vladak/workmon/README.md

# workmon

In the beginning of the [pandemic](https://en.wikipedia.org/wiki/COVID-19), the company offices went closed rather quickly and I found myself working with my laptop placed on a piano. The initial shock held for a long time, I spent couple of months working like that. This was not good for my posture (mental and physical) at all.

Later on, I built a very nice setup around [motorized standing desk](https://www.fully.com/standing-desks.html) with all the bells and whistles - quite meticulous cable management, custom oak wooden top (expensive), BenQ LED light placed on external display, IKEA pegboard on the wall next to the table to hold the essentials (like noise cancelling headphones, pens, SPARC assembly cheat-sheet, etc.), ~[Varmilo keyboard](https://en.varmilo.com/)~ [Keychron keyboard](https://www.keychron.com/products/keychron-v10-max-qmk-via-wireless-custom-mechanical-keyboard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), [Grovemade desk pad](https://grovemade.com/product/matte-desk-pad/?initial=533), WiFi extender AP mounted underneath the desk, professionally framed pictures/drawings on the wall, a small plant, etc.

Using this setup allowed me to be very productive, possibly more productive than in the office, to the point when I wanted to know more about how I work to make the increased [productivity levels sustainable](https://drmaciver.substack.com/p/people-dont-work-as-much-as-you-think).

When shopping around for parts of another project on [Adafruit](https://adafruit.com), I remembered an interesting presentation from [GrafanaCon 2021](https://grafana.com/about/events/grafanacon/2021/) called [WFH habits during lockdown told by Grafana](https://grafana.com/go/grafanaconline/2021/grafana-wfh-habits/) where the presenter used sensor paired with Grafana to monitor her WFH behavior w.r.t. breaks etc. This made me throw some more stuff to the Adafruit order, scavenge some parts laying around and make my own version of work habits monitoring setup.

My goal is to provide the following functionality:
  - determine the hours I work (per day/week)
    - turn on a warning that I should wrap for the day
    - send an alert if I have been working for too long in a given week (via Grafana + PagerDuty)
  - warn if I spend too much configuous time sitting/standing
    - similarly warn if I work for too long without a break
  - monitor the working environment, esp. CO2 concentration, and alert if above given threshold

## Hardware

- [ReverseTFT Feather](https://www.adafruit.com/product/5691)
- TP-link P110 smart WiFi plug
  - my primary display is connected to this plug 
  - this is used to detect my presence in front of the computer. This works with sufficient degree of precision because my display has the saver set just to 3 minutes.
    - while the presence could be detected in software, I wanted to avoid any changes whatsoever to the software of my company provided laptop. Other metrics such as light emitted by the display would not be as reliable.
- [US-100 Ultrasonic Distance Sensor](https://www.adafruit.com/product/4019) connected directly (soldered) to the Feather
  - to determine if the table is up/down
- iPhone headphones transparent plastic box used as a housing for the distance sensor
  - to be mounted underneath the table at the back in order not to cause measurement interference with my legs/chair etc.
- 4-strand phone cable to connect the distance sensor to the Feather
  - originally I wanted the cable to be split and outfitted with RJ11 connectors and connected using a connecting piece so that the sensor can be easily disconnected, however this connection turned out to be flaky so in the end I soldered it.
- [QtPy](https://learn.adafruit.com/adafruit-qt-py) with temperature/humidity and CO2 sensors
  - running the code from my [shield project](https://github.com/vladak/shield)
  - publishing messages with the metrics to a MQTT topic. The Feather will subscribe to the topic and handle the values.
- [3D printed stand](https://learn.adafruit.com/stand-for-feather-esp32-with-reverse-tft)

This is the 2nd version. See below for older versions.

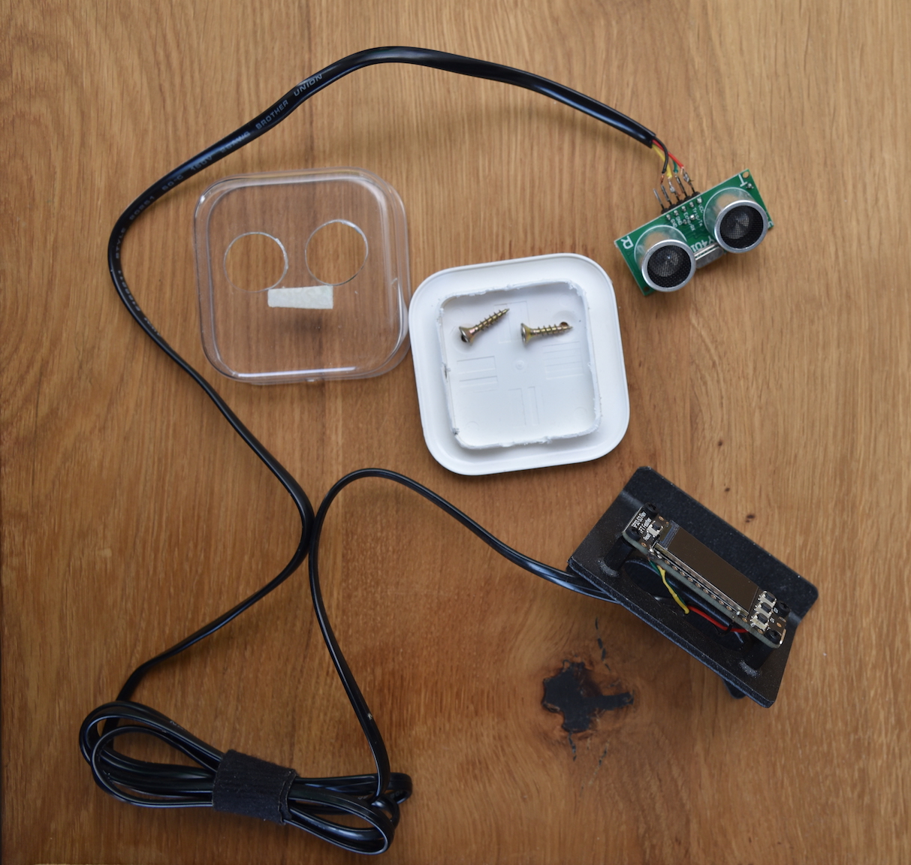
[picture p1: img/parts.jpg]
some of the parts

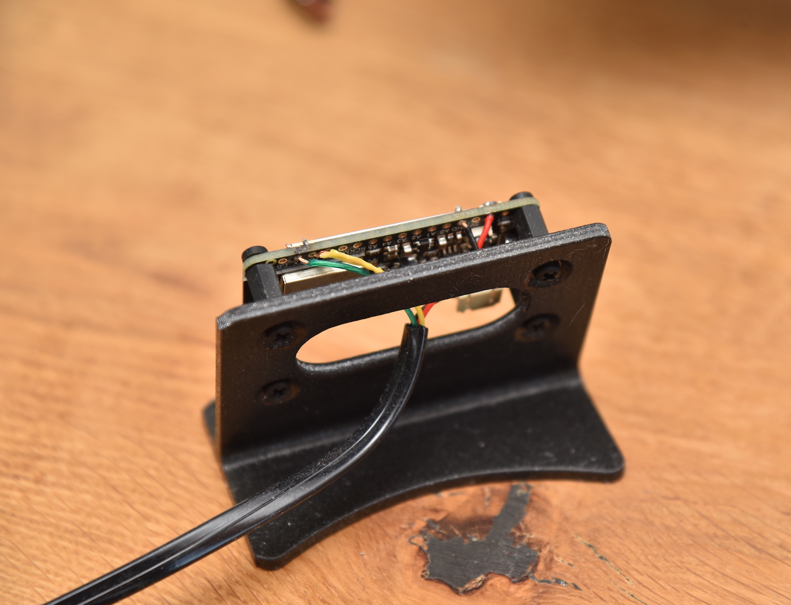
[picture p2: img/back.jpg]
back of the Feather

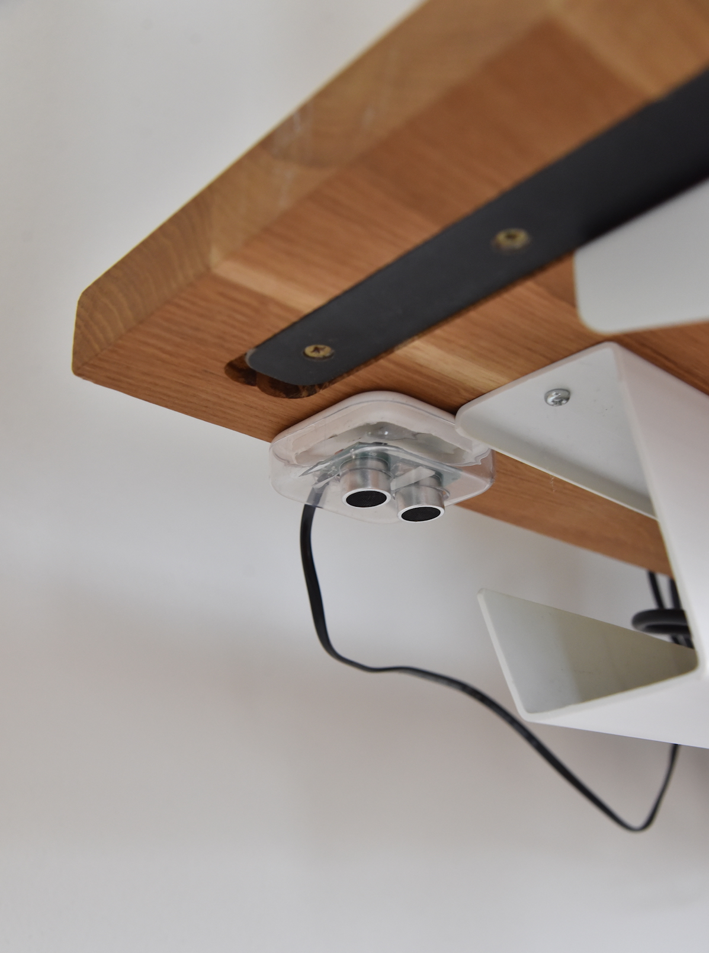
[picture p3: img/table.jpg]
ultrasonic sensor mounted underneath the table

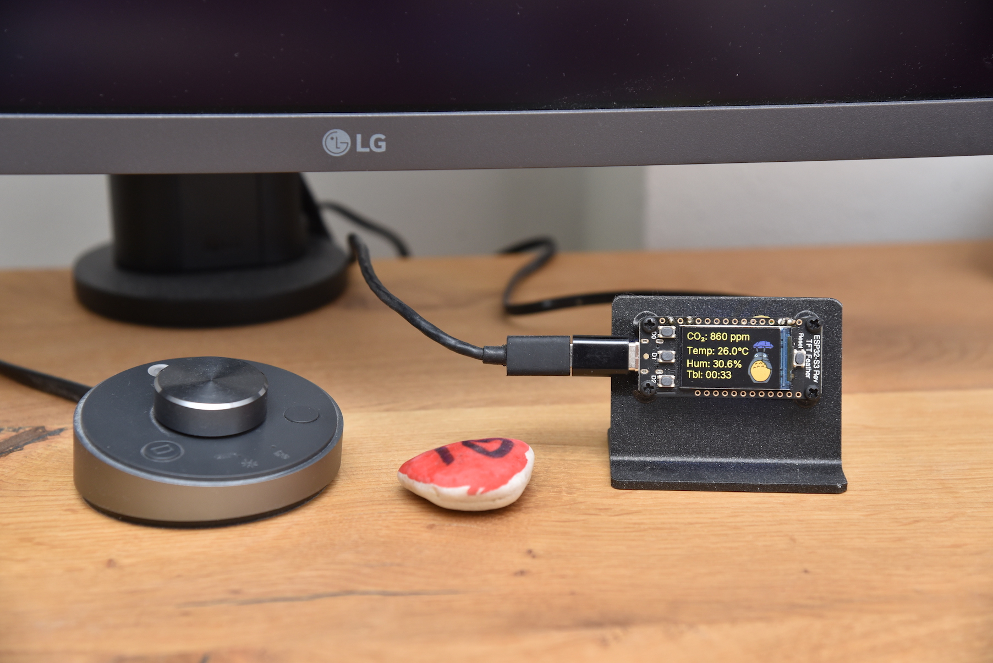
[picture p4: img/front.jpg]
front side


## Features

- by default a set of metrics is displayed: CO2, tmperature, humidity and the duration of the current table position. Also, image is displayed if available.
- The CO2 metric displayed will turn red if the value is greater than a configured threshold.
  - also, the Neopixel on the back side will start blinking red
- If the table is in the same position for too long (configurable) while the monitored power is on, the image will be changed and the neopixel on the back side will start blinking blue.
  - the table state tracking depends on the monitored power to be above certain threshold (i.e. **computer** display being on)
- If the monitored power is on longer than configured threshold, the neopixel will start blinking green.
- the display is on only during certain hours (configurable)
- if the display is off, pushing any D0/D1/D2 button will turn it on for a minute.

The blinking of the neopixel is prioritized so that it will blink with the color corresponding to the highest priority alert.

## History

Originally, this was based on a Raspberry Pi with a directly attached USB hub to connect the distance reader and 
a [light bulb with 3 lights](https://www.adafruit.com/product/5127) which was used to do the alerting.
The ultrasonic distance sensor was placed in original iPhone plastic box (the one with the transparent cover) with two holes for the sensor.
The Rpi died suddenly and I found more fun "architecture" based on microcontrollers.

Also, I believe the placement of the distance sensor was causing [value flapping](https://github.com/vladak/workmon/issues/10). 
It was attached with double sticky tape the white cable holder underneath the table on the right side and was not fully in horizontal position which is 
possibly made it to get erroneous readings. Another possibility is some interaction with the Linux running on the Raspberry Pi.

## Setup

### NTP server

The code assumes there is NTP server running and responding on the default IPv4 gateway.

### TP-link P110

Install the Tapo app on a mobile phone. Register new account, remember the user ID and password as these will be necessary. Allow third-party API access within the app.
This is necessary to get the current power reading via API working.

Setup the plug so that it connects to dedicated (IoT) WiFi network with IP address staticly assigned via DHCP. This is needed to be able to read the power consumption
values using the same host/IP hard-coded in the configuration.

Set up and configure https://github.com/vladak/plug2mqtt/ somewhere on the IoT network (say on a Raspberry Pi) to publish the state of the plug, notably the power consumption.

### Feather

Solder the US-100 (in UART mode) per the US-100 guide.

### Metrics (prerequisites)

- The code assumes that environmental metrics are published to a certain MQTT topic.
  - For that I use https://github.com/vladak/shield with a QtPy.
- The code takes the power consumption value from MQTT.
  - https://github.com/vladak/plug2mqtt/ is used

### Prometheus

The Prometheus configuration needs to have the bits for the above mentioned pre-requisites.
For the table distance the MQTT exporter configuration in `/etc/prometheus/mqtt-exporter.yaml` needs to be augmented
with this section:
```yaml
metrics:
  -
    # The name of the metric in prometheus
    prom_name: distance
    # The name of the metric in a MQTT JSON message
    mqtt_name: distance
    # The prometheus help text for this metric
    help: distance
    # The prometheus type for this metric. Valid values are: "gauge" and "counter"
    type: gauge
```

### Grafana

Assumes the Prometheus data source is already set up.

Perform the following setup on the **Grafana server**:

- Use [dashboard provisioning](https://grafana.com/docs/grafana/latest/administration/provisioning/#dashboards) with [work-dashboard.json](https://github.com/vladak/workmon/blob/main/work-dashboard.json)
- Set up the service to publish annotations using the instructions on https://github.com/vladak/mq2anno

## Configure

Here is list of tunables. Most of these are mandatory.

Purpose | Name
---|---
`ntp_server` | hostname or IP address of NTP server. If left not configured, the default router will be used.
`tz_offset` | time zone offset, default 1.
`SSID` | WiFi SSID
`password` | WiFi password
`broker`  | MQTT broker IP address
`broker_port` | MQTT broker port
`log_level` | log level (e.g. "info" or "debug")
`mqtt_topic_env` | MQTT topic to subscribe for environmental metrics
`mqtt_topic_power` | MQTT topic to subscribe for power state of the display
`mqtt_topic` | MQTT topic to publish data to (e.g. table state)
`distance_threshold` | threshold for table distance from the ground (to infer whether table is up or down), in centimeters
`power_threshold_watts` | threshold for the power consumption of the display (to infer whether the display is on or off), in Watts
`co2_threshold` | CO2 threshold for alerting, in PPM
`last_update_threshold` | when no data is received within this threshold, display N/A, in seconds
`break_threshold_seconds` | if the display is considered to be on for more than this time duration, make an alert, in seconds
`icon_paths` | paths to the icon files (array of 2 paths - the first is the default, the second is displayed when the table has been in given state for more than the threshold below)
`table_state_dur_threshold` | the duration for table alerting, in seconds
`start_hr` | hour (24 hr format) after which the TFT display should be on (inclusive)
`end_hr` | hour (24 hr format) after which the TFT display should be off (exclusive)
`font_file_name` | path to the font file

Example `secrets.py` configuration:

```python
secrets = {
    "SSID": "FOO",
    "password": "XYZ",
    "broker": "172.40.0.3",
    "broker_port": 1883,
    "log_level": "info",
    "mqtt_topic_env": "devices/pracovna/qtpy",
    "mqtt_topic_power": "devices/plug/pracovna",
    "mqtt_topic": "devices/pracovna/featherTFT",
    "distance_threshold": 90,
    "power_threshold_watts": 35,
    "co2_threshold": 1000,
    "last_update_threshold": 60,
    "break_threshold_seconds": 2700,
    "icon_paths": [
        "/images/icons8-totoro-120.bmp",
        "/images/icons8-totoro-120-umbrella.bmp",
    ],
    "table_state_dur_threshold": 1800,
    "start_hr": 8,
    "end_hr": 23,
    "font_file_name": "fonts/Inter-Regular-25.pcf",
}
```

## Install

It assumes there are 2 120x96 images in the `images` directory. It will do fine without them, however the table position alerting will resort just to blinking the diode.

With [`circup`](https://github.com/adafruit/circup/) installed and the Feather connected over USB (assuming Linux distro):
```
circup install -r requirements.txt
cp -R images/ fonts/ *.py settings.toml /media/$USER/CIRCUITPY/
```

## Generating bitmap font

Using bitmap fonts makes the display more readable and nicer. Also, some of the glyps like the circle in °C can be actually displayed.
The font however has to be converted to fit onto the flash and then it has to be used in a special way for quick display.

1. grab the fonts from https://rsms.me/inter/
2. convert the `extras/ttf/Inter-Regular.ttf` into BDF (use 25 pixels size) using https://fontforge.github.io/
3. convert the BDF into PCF for smaller size using https://adafruit.github.io/web-bdftopcf/
4. copy the resulting file to the `CIRCUITPY` directory

## Guides:

- US-100: https://learn.adafruit.com/ultrasonic-sonar-distance-sensors/python-circuitpython
- fonts: https://learn.adafruit.com/custom-fonts-for-pyportal-circuitpython-display/

## Lessons learned

- monitoring work hours is dicey. It might feel good to put in the expected amount of work hours, however I was often tremendously productive (esp. in terms of quality of the output) when I worked less hours and made quality breaks.
- so far, with the state of CircruitPython at least, microcontroller based projects are all about tight loops, e.g. in order to sample button pressed events.
  - There are some actions that might shed some time from that loop that are not so obvious, e.g. the US-100 distance reading might require up to 0.4 seconds
- due to the very dynamic nature of the microcontroller ecosystem, the workarounds for various issues are omnipresent
  - I dislike having workarounds in place because such bloat accumulates over time and leads to non seamless upgrades, so I try to contribute to upstream.
  - On the other hand, chasing bugs in the underlying ROTS operating system costs lots of time and effort so sometimes it is wise to just reset the microcontroller via [`safemode.py`](https://learn.adafruit.com/circuitpython-safe-mode/safemode-py) and drive on, esp. for these non-critical projects.
- like with any Python code, scrubbing the code with tools (black/pylint/flake8/isort) prevents some issues during the runtime, but here it is even more important because runtime troubleshooting might involve tinkering with the hardware which costs extra time
  - some level of testing, where possible, is also handy, for the same reason.
- it is nice to have a friend with a Dremel
  - or a shared area with such tools
- it is nice to be able to 3-D print stuff on demand
  - totally possible thanks to [Prusa community](https://world.prusa3d.com/)
