vladak/workmon/img/work-dashboard.png

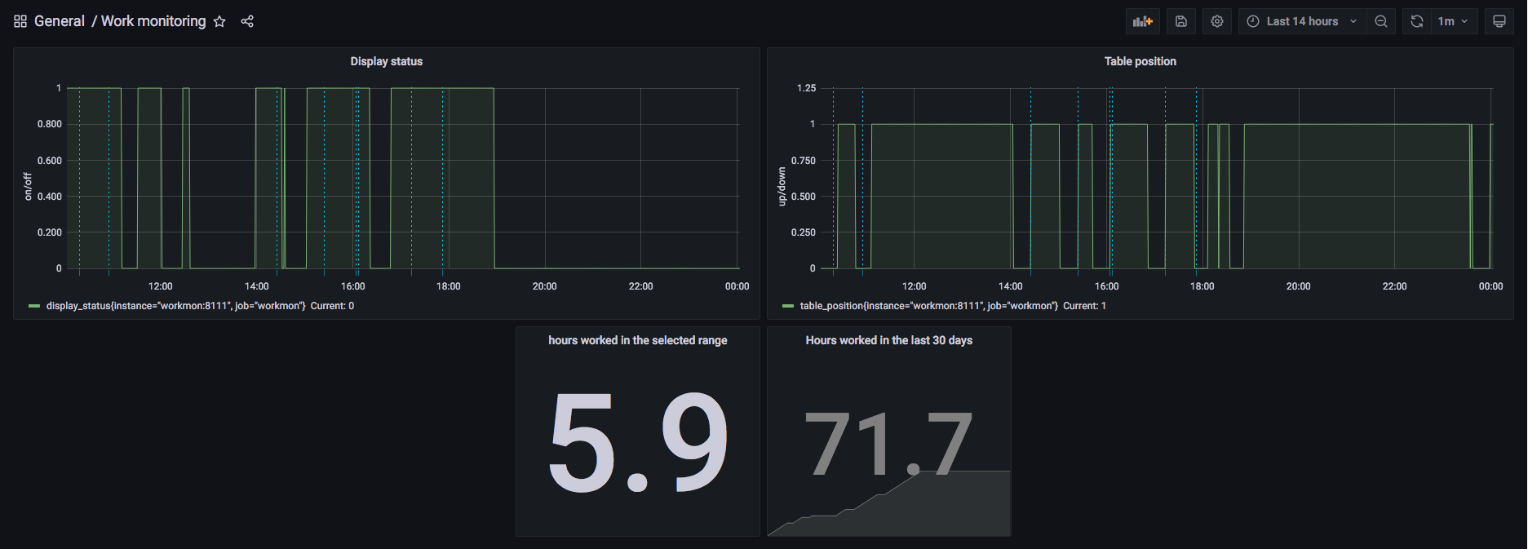
img/work-dashboard.png
