vladak/workmon/img/assembled.jpg

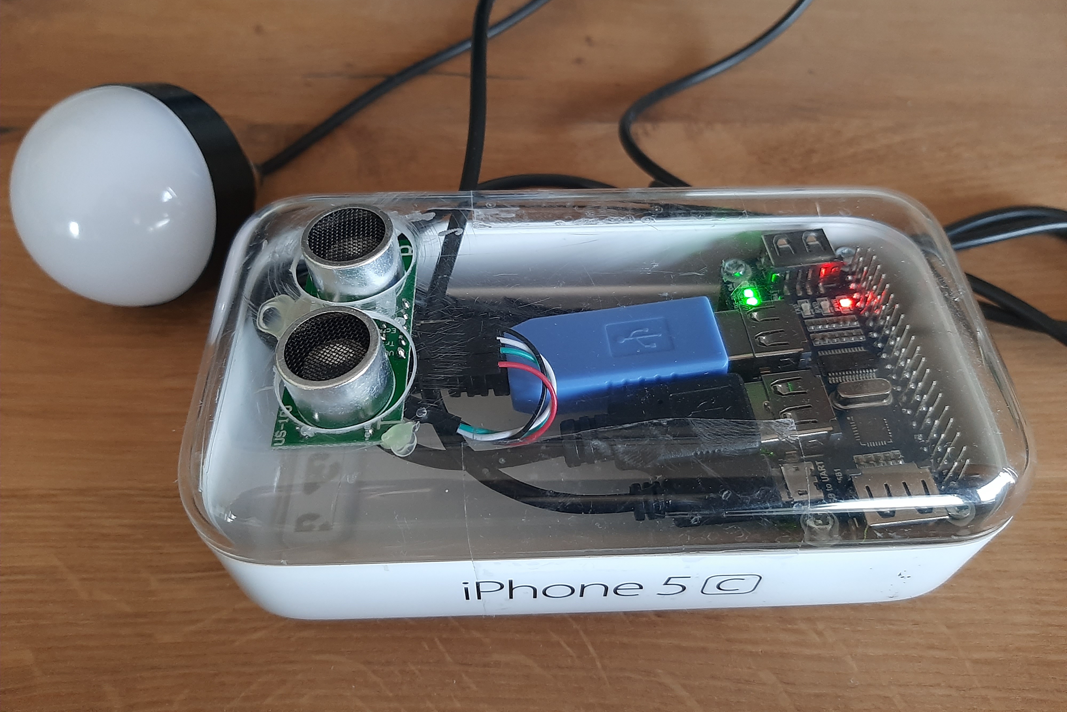
img/assembled.jpg
