vladak/workmon/(threads)

Thread 13 (2024-02-07):

draw Celsius sign properly

vladak, 2024-02-07:
The small circle next to the °C is not drawn on the display with the current font. This might involve using a bitmap font.

vladak, 2024-02-28:
Inspiration from https://github.com/good-enough-technology/Good-Enough_Air-Quality-Device_CO2-SCD4x_PM-SEN5x_CircuitPython/blob/7281c01b2afe584eab1840a4284faa2a22eb19a1/code.py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 is to use https://rsms.me/inter/:
```python
    font = terminalio.FONT
    try:
        font = bitmap_font.load_font("Inter-Thin-30.bdf")  # Load the font file
        font.load_glyphs(code_points='ABCDEFGHIJKLMNOPQRSTUVWXYZabcdefghijklmnopqrstuvwxyz1234567890- ().,:!?/\\%+@~')
        font.load_glyphs('°³µ')  # pre-load glyphs for fast printing
    except:
        pass
    label = Label.Label(font, text="Good-\n\tEnough\n.technology")
```
and then the `°` character can be used normally.

Closed 2024-02-29.

Thread 17 (2024-02-07):

warn to make a pause

vladak, 2024-02-07:
The original functionality had a warning when the power was on for too long. The warning might be in the form of different image displayed and different color of the blinking neopixel.

With such functionality, multiple alerts happening at once will need to be reconciled (prioritized) somehow.

Closed 2024-03-12.

Thread 20 (2024-02-07):

mount the US-100 in headphone enclosure

vladak, 2024-02-07:
Need to drill the holes with a Dremel first.

vladak, 2024-03-08:
Done. Used a hand drill for the holes in the transparent lid and then used Dremel with the sanding cylinder to smooth the edges. Then made a small incut for the cable. As for the white bottom, I used Dremel with the small rotating disc to remove the headphone holder and then smoothened it out. Finally drilled two small holes in the white bottom - there were 2 small circular depressions just in the right positions.

Closed 2024-03-08.

Thread 24 (2024-02-08):

consider handling OSError (timeout) for NTP requests

vladak, 2024-02-08:
The NTP sometimes times out. This will lead to the microcontroller reset which resets the table tracking. Consider handling the timeout by retrying couple of times.

Closed 2024-02-09.

Thread 26 (2024-05-24):

add debouncing for the button presses

vladak, 2024-05-24:
Use some of the ideas from:
  - https://learn.adafruit.com/make-it-switch/debouncing
  - https://learn.adafruit.com/debouncer-library-python-circuitpython-buttons-sensors/basic-debouncing

vladak, 2024-05-27:
It might be also useful for stabilizing the table height measurements however at this point that does not seem to be flaky.

Closed 2025-04-04.
