vladak/workmon/safemode.py

"""
safe mode handling
"""

import microcontroller

# pylint: disable=import-error
import supervisor

reason = supervisor.runtime.safe_mode_reason
if reason == supervisor.SafeModeReason.HARD_FAULT:
    # pylint: disable=no-member
    microcontroller.reset()  # Reset and start over.
elif reason == supervisor.SafeModeReason.WATCHDOG:
    # pylint: disable=no-member
    microcontroller.reset()  # Reset and start over.

# Otherwise, do nothing. The safe mode reason will be printed in the
# console, and nothing will run.
