vladak/workmon/logutil.py

#
# CDDL HEADER START
#
# The contents of this file are subject to the terms of the
# Common Development and Distribution License (the "License").
# You may not use this file except in compliance with the License.
#
# See LICENSE.txt included in this distribution for the specific
# language governing permissions and limitations under the License.
#
# When distributing Covered Code, include this CDDL HEADER in each
# file and include the License file at LICENSE.txt.
# If applicable, add the following below this CDDL HEADER, with the
# fields enclosed by brackets "[]" replaced with your own identifying
# information: Portions Copyright [yyyy] [name of copyright owner]
#
# CDDL HEADER END
#

"""

logging utilities

"""

import adafruit_logging as logging


def get_log_level(level):
    """
    :param level: expressed in string (upper or lower case) or integer
    :return: integer representation of the log level or None
    """
    if isinstance(level, int):
        return level

    # This could be a string storing a number.
    try:
        return int(level)
    except ValueError:
        pass

    # Look up the name in the logging module.
    try:
        value = getattr(logging, level.upper())
        if isinstance(value, int):
            return value

        return None
    except AttributeError:
        return None
