vladak/workmon/(commit log)

2022-01-24 on sensors
2022-01-24 add steps to enable the Current reading
2022-01-24 initial addition of the program that acquires sensor data
2022-01-28 remove the CT sensor based solution for detecting presence
    First problem I found was that CT sensors have problems with noise due to manufacturing and design problem (https://www.casler.org/wordpress/low-current-measurement-performance-of-the-sct013/), then I found that the HAT for the CT sensors has a Current range as well and the last point was that I found out that the CT sensor cannot be used only for measuring single lead wire current. Thus, I needed to find a different solution, possibly based on smart sockets.
2022-01-28 on holes
2022-01-29 handle invalid device path
2022-01-31 add real threshold for display power
2022-02-01 print break time in std format
2022-02-02 on exit from the context manager, finish the current task and exit
2022-02-04 publish blinking events as MQTT messages
    fixes #7
    [mqtt.py]
2022-02-16 mention glue
2022-02-17 on the bulb mount
2024-01-14 add isort config that works well with black
    [.isort.cfg]
2024-01-27 change icon if table is in the same position for too long
    [code.py]
2024-01-29 reset table state on display off
    [code.py]
2024-01-29 fix some pylint issues
    [code.py]
2024-01-29 table state reset in user_data
    [code.py]
2024-01-30 handle get() failure
    one of them, at least
    [code.py]
2024-01-30 replace requests with local NTP to get current time
    [code.py]
2024-02-01 handle publish failure by reconnecting
    [code.py]
2024-02-02 allow for recording button presses
2024-02-03 register any "front" button press
2024-02-03 tidy up button init code
2024-02-07 add workaround for https://github.com/adafruit/circuitpython/issues/8887
    [code.py]
2024-02-07 refactor power handling into a function
2024-02-07 more import ordering fixes
    [code.py]
2024-02-07 switch to different implementation
2024-02-07 remove the Raspberry note
2024-02-07 move TODOs to issues
    [code.py]
2024-02-07 move TODO to issues
    [binarystate.py]
2024-02-07 skip the us100 library
    [.isort.cfg]
2024-02-07 fix isort
    [.isort.cfg]
2024-02-08 add 3D printing link
2024-02-08 fix D1/D2 button handling
    fixes #14
    [button.py, code.py]
2024-02-09 handle NTP failure
    fixes #24
    [code.py]
2024-02-09 handle table state duration longer than 24 hours
    fixes #15
    [code.py]
2024-02-09 remove the workaround for invalid US-100 readings
    fixes #19
    [code.py]
2024-02-11 handle DST
    fixes #12
    [code.py, test_timeutil.py, timeutil.py]
2024-02-19 publish table alert
    fixes #23
    [code.py]
2024-02-29 use bitmap fonts by default
    fixes #13
    [code.py]
2024-03-12 add break warning
    fixes #17
    [code.py]
2024-03-13 mention the phone cable
2024-04-16 handle safe mode entered as a result of hard fault
    fixes #25
    [safemode.py]
2024-05-27 handle MQTT errors during publish()
    fixes #27
    [code.py, mqtt.py]
2024-11-24 suppress pylint error reported by newer pylint version
    [code.py, mqtt.py]
2025-04-04 use 1 second socket timeout for NTP queries
2025-04-04 update the display only once a second
    fixes #30
    [code.py]
2025-04-04 print button state only if button press was registered
2025-04-04 add NTP parameters (server, time zone offset)
    fixes #29
    [code.py]
2025-04-04 use debouncer
    fixes #26
    [button.py, code.py]
2025-04-04 remove extra button updates
2026-04-07 handle internal watchdog timeout
    Sometimes the microcontroller throws internal watchdog timeout. Handle this by resetting.
    [safemode.py]
2026-04-07 disable pylint warning for board.NEOPIXEL
2026-08-26 switched to Keychron V10
